bluemelony12/Hexapod_Robot/README.md

# Hexapod_Robot
Hexapod_Robot

소스 파일, 구동 영상 및 졸업 논문

Src/ C files(main)

Inc/ header files
