bluemelony12/Hexapod_Robot/Hexapod_Research_Paper/1.cover.pdf

6족 보행 로봇을 이용한
로봇 메커니즘 제작 및 이해

안양대학교

전기전자공학과

이재홍 김기철
