bluemelony12/Hexapod_Robot/Inc/main.h

/*******************************************************************************
  
  * File name :  TIM_4 / main.h 
  
			* Application model : Nucleo_F103 Board  
 
			* Ver4.0
			* January 23. 2017
			* by Sang-min Kim, Jae-Il Kim  &  Dong-hyuk Cha
 
 ****************************************************************************** */
  
/* Define to prevent recursive inclusion -------------------------------------*/
#ifndef __MAIN_H
#define __MAIN_H

/* Includes ------------------------------------------------------------------*/
#include "stm32f1xx_hal.h"
#include "stm32f1xx_nucleo.h"


#endif /* __MAIN_H */

// ------------------------------------------------------------------- //
